Makerfabs/Maduino-Zero-4G-CAT1-A7670X/README.md

# Maduino-Zero-4G-CAT1-A7670X
Maduino Zero 4G LTE CAT1 A7670X
