Makerfabs/Maduino-Zero-4G-CAT1-A7670X/hardware/Maduino Zero 4G LTE A7670X v1.1.PDF

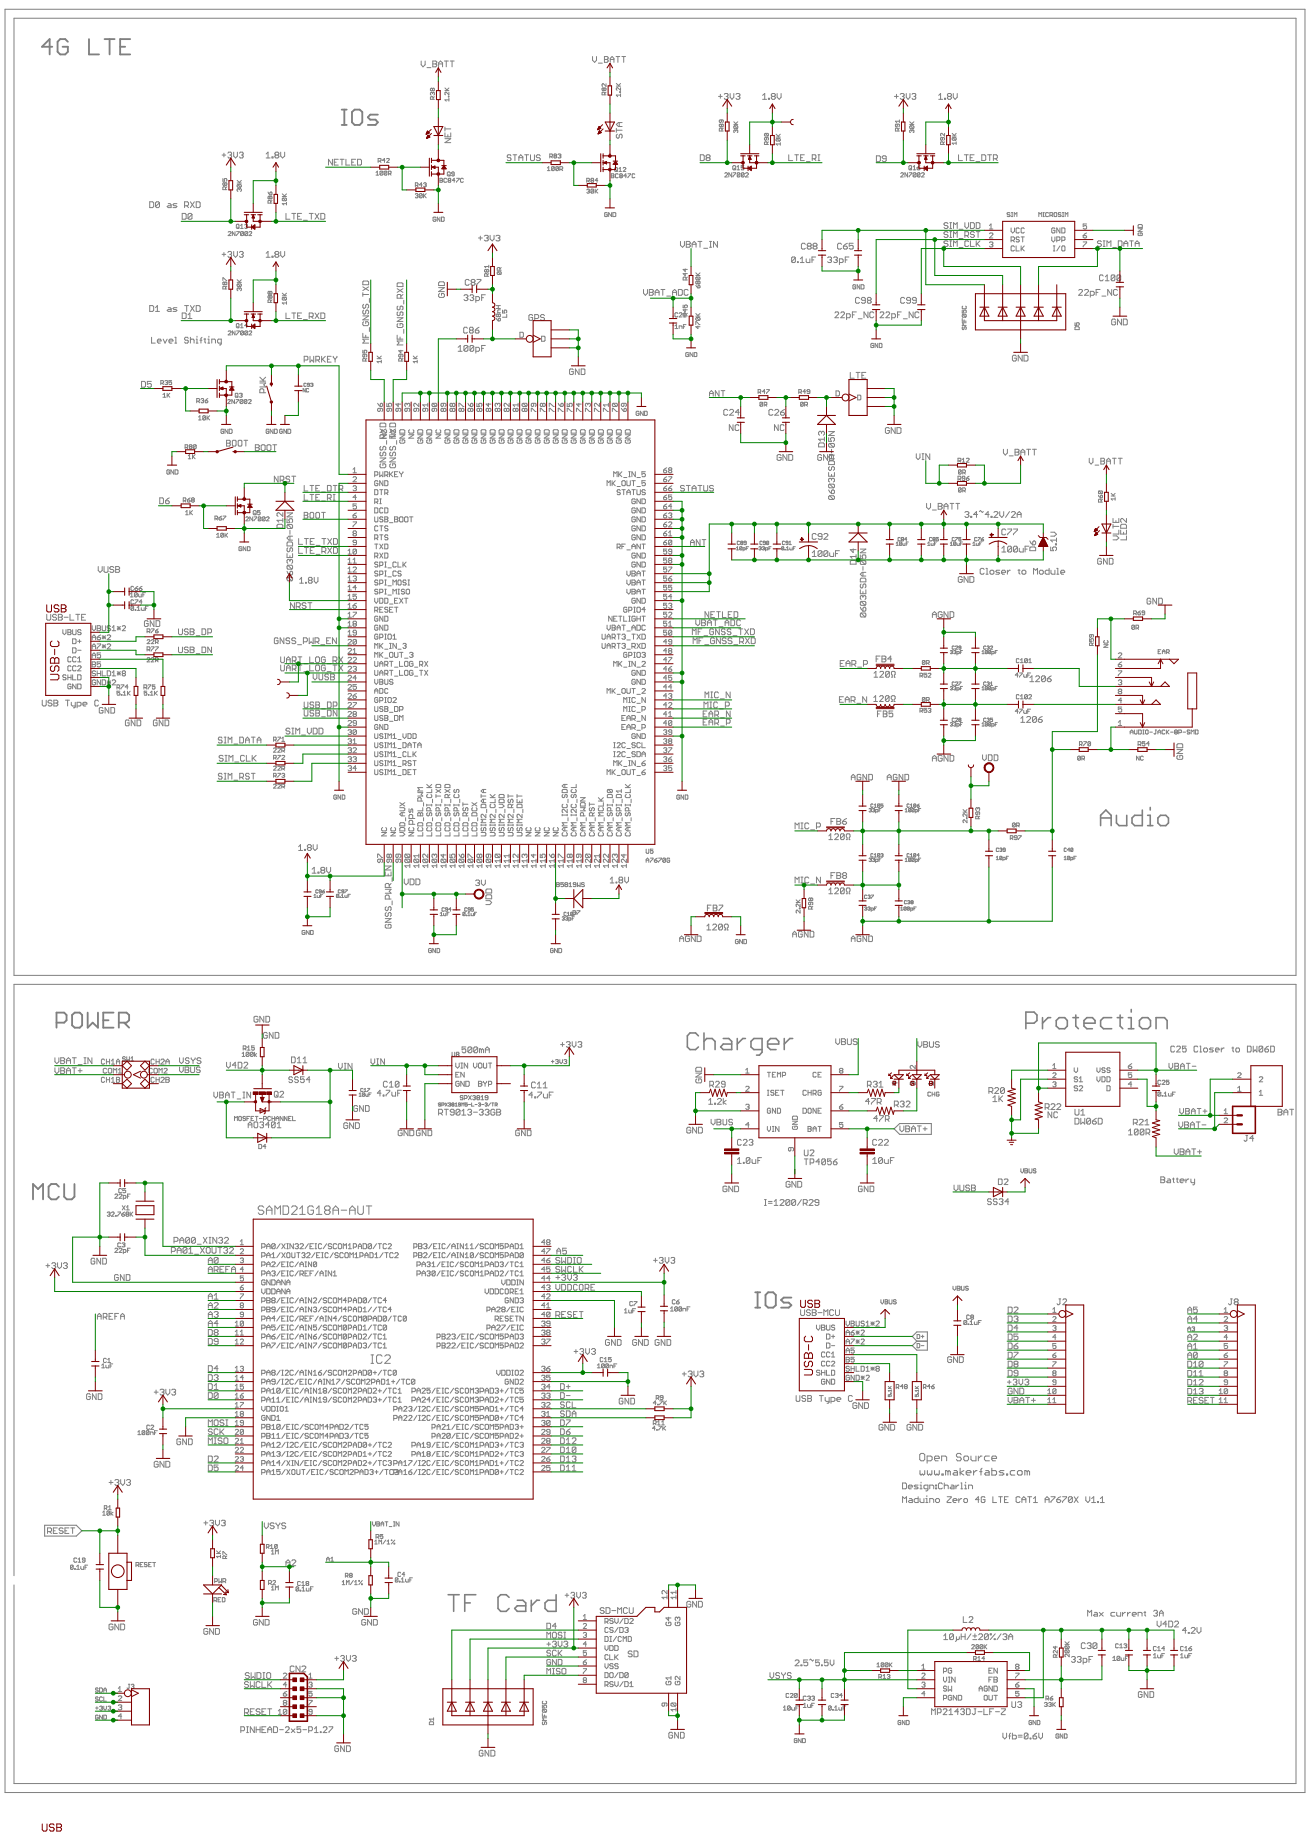
[picture p1: page 1]
