Makerfabs/Maduino-Zero-4G-CAT1-A7670X/hardware/Maduino Zero 4G LTE A7670X v1.1.brd

## EAGLE design hardware/Maduino Zero 4G LTE A7670X v1.1.brd (2023-10-08)

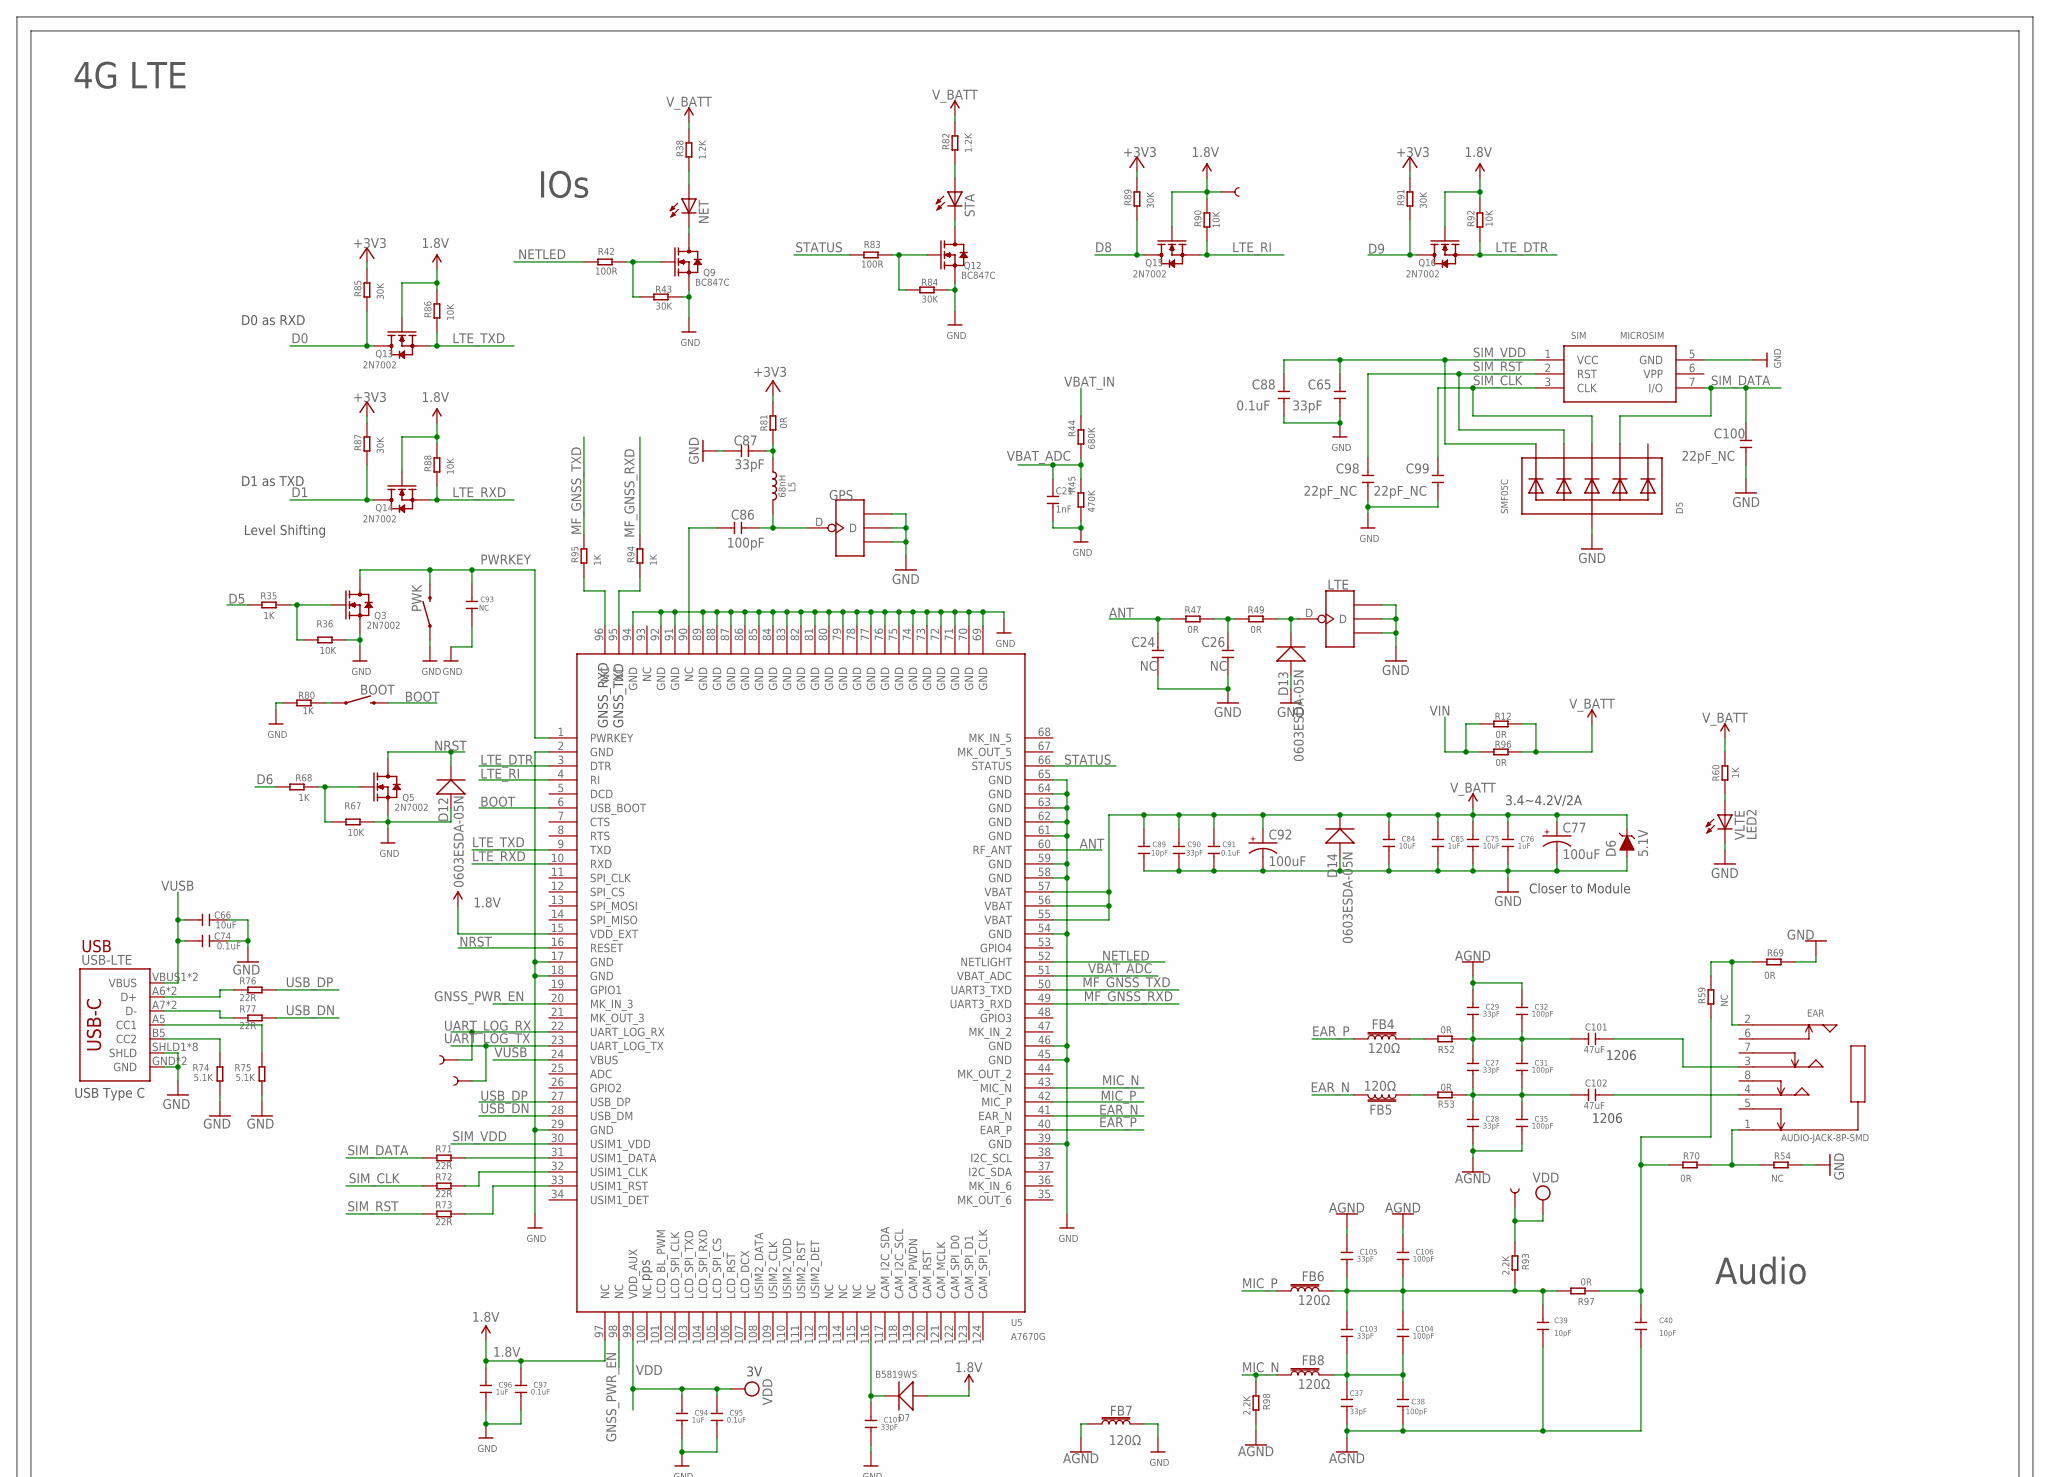
[picture p2: schematic Maduino Zero 4G LTE A7670X v1.1.sch, part in row 1, column 1]

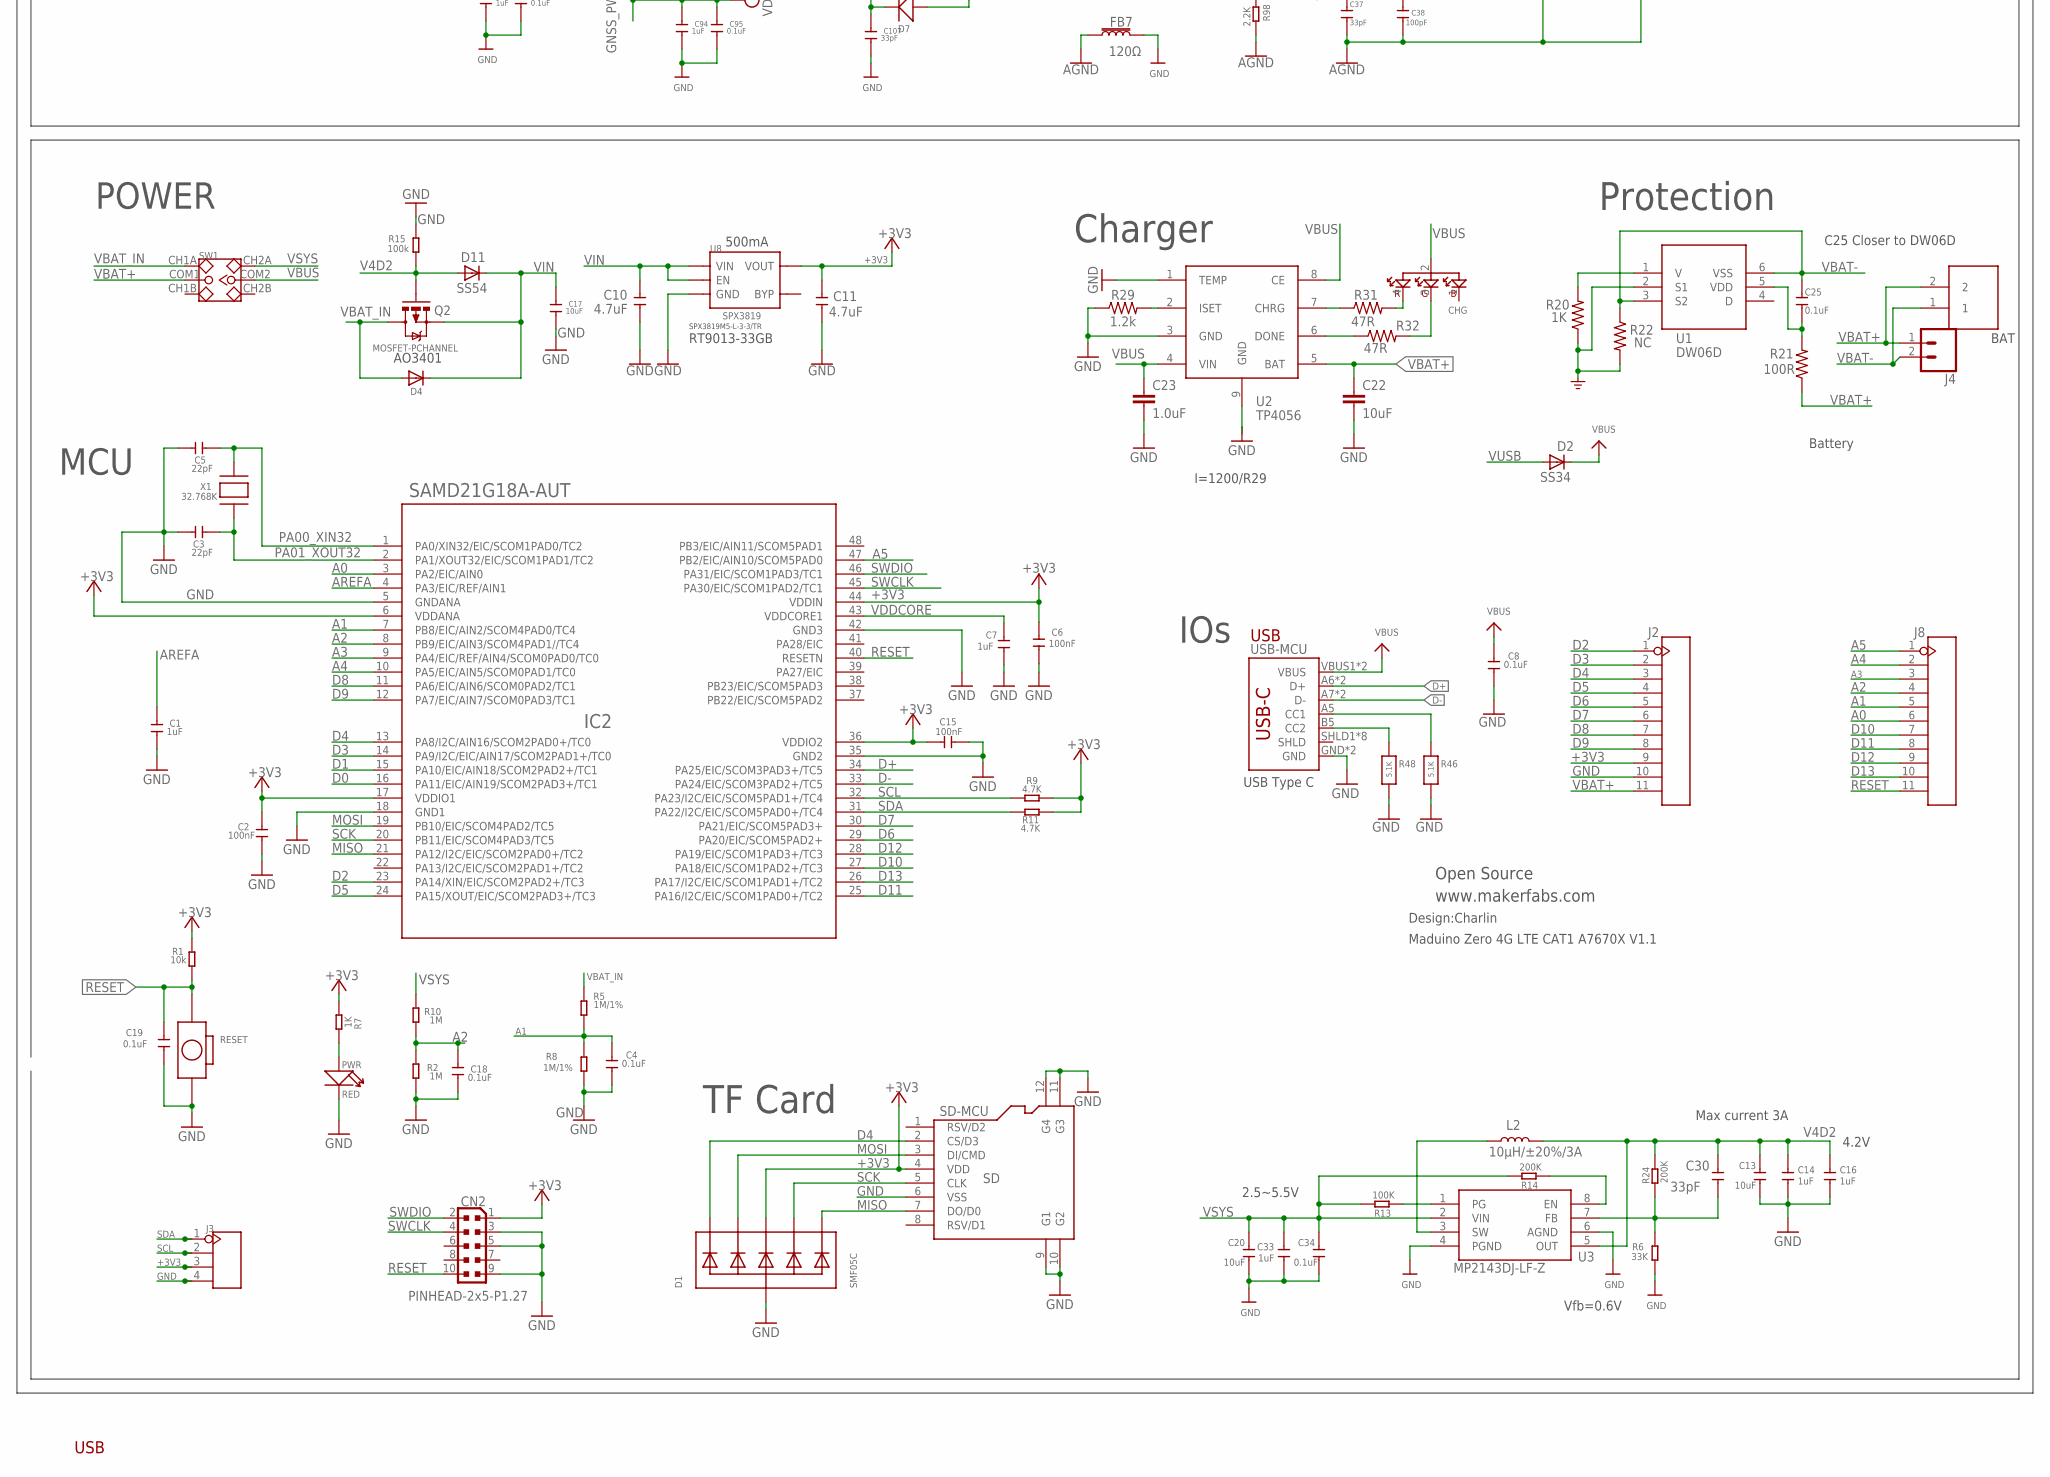
[picture p3: schematic Maduino Zero 4G LTE A7670X v1.1.sch, part in row 2, column 1]

Parts:
BAT: PH2.0-2P-90-DIP
BOOT: MOMENTARY-SWITCH-SPST-SMD-6.0X3.5MM; TACTILE_SWITCH_SMD_6.0X3.5MM
C1, C7, C14, C16, C33, C76, C85, C94, C96: 1uF; 0603
C2, C6, C15: 100nF; 0603
C3, C5: 22pF; 0603
C4, C8, C18, C19, C25, C34, C74, C88, C91, C95, C97: 0.1uF; 0603
C10, C11: 4.7uF; 0603
C13, C17, C20, C22, C66, C75, C84: 10uF; 0603
C21: 1nF; 0603
C23: 1.0uF; 0603
C24, C26, C93: NC; 0603
C27, C28, C29, C30, C37, C65, C87, C90, C103, C105, C107: 33pF; 0603
C31, C32, C35, C38, C86, C104, C106: 100pF; 0603
C39, C40, C89: 10pF; 0603
C77, C92: 100uF; EIA3528
C98, C99, C100: 22pF_NC; 0603
C101, C102: 47uF; DISCRETE_C1206
CHG: E6C0606RGBC3UDA; SMD4-160L160W
CN2: PINHEAD-2x5-P1.27; PINHEAD_2X05_127
D1, D5: SMF05C; SOT363
D2: SS34; DO-214AC
D4: DIODESOD-323F; SOD-323F
D6: 5.1V; SOD-323
D7: B5819WS; SOD323
D11: SS54; DO-214AC
D12, D13, D14: 0603ESDA-05N; DISCRETE_SOD523
EAR: AUDIO-JACK-8P-SMD; AUDIO8P-SMD-3.5-14.5X6.1X4.0MM
FB4, FB5, FB6, FB7, FB8: 120Ω; 0603
GPS: ANTENNA-U-FL; 4P-U-FL
IC2: SAMD21G18A-AUT; TQFP48-7X7
J2, J8: HEADER-11P-2.54; 11P-2.54
J3: HEADER-4P-60/35MILROUND; 4P-65/35ROUND
J4: CONN_02LOCK; 1X02_LOCK
L2: 10µH/±20%/3A; SRN6045
L5: 68nH; L0603
LTE: ANTENNA-U-FL; 4P-U-FL
NET: NET; CHIP-LED0805
PWK: MOMENTARY-SWITCH-SPST-SMD-6.0X3.5MM; TACTILE_SWITCH_SMD_6.0X3.5MM
PWR: RED; LED-0603
Q2: MOSFET-PCHANNEL; SOT23-3
Q3, Q5, Q13, Q14, Q15, Q16: 2N7002; SOT23
Q9, Q12: BC847C; SOT23
R1: 10k; R0603
R2, R10: 1M; R0603
R5, R8: 1M/1%; R0603
R6: 33K; R0603
R7, R35, R60, R68, R80, R94, R95: 1K; R0603
R9, R11: 4.7K; R0603
R12, R47, R49, R52, R53, R69, R70, R81, R96, R97: 0R; R0603
R13: 100K; R0603
R14, R24: 200K; R0603
R15: 100k; R0603
R20: 1K; 0603
R21: 100R; 0603
R22: NC; 0603
R29: 1.2k; 0603
R31, R32: 47R; 0603
R36, R67, R86, R88, R90, R92: 10K; R0603
R38, R82: 1.2K; R0603
R42, R83: 100R; R0603
R43, R84, R85, R87, R89, R91: 30K; R0603
R44: 680K; R0603
R45: 470K; R0603
R46, R48: 5.1K; 0603-NO
R54, R59: NC; R0603
R71, R72, R73, R76, R77: 22R; R0603
R74, R75: 5.1K; R0603
R93, R98: 2.2K; R0603
RESET: BOTTON-2P-90D; 2P-7.62X3.56-90D
SD-MCU: SD; 8P-SMD
SIM: MICROSIM
STA: NET; CHIP-LED0805
SW1: SWITCH-2CH-6P; 6P-2CH-2.54-7.6X3.0
TP1, TP2, TP3, TP6: TEST-POINT3; PAD.03X.03
U1: DW06D; SOT-23-6
U2: TP4056; SOP8-1.27P
U3: MP2143DJ-LF-Z; TSOT23-8
U5: A7670G
U8: SPX3819; SOT23-5
USB-LTE: USB_C5; USB-C-16P-5
USB-MCU: USB_C5; USB-C-16P-5
VLTE: LED2; CHIP-LED0805
X1: 32.768K; XTAL3215

Connections:
1.8V: C96.2, C97.2, D7.+, Q13.1 (G), Q14.1 (G), Q15.1 (G), Q16.1 (G), R86.2, R88.2, R90.2, R92.2, TP6.P$1, U5.15 (VDD_EXT), U5.97 (NC)
+3V3: C2.2, C6.1, C11.2, C15.1, CN2.1, D1.4 (C3), IC2.6 (VDDANA), IC2.17 (VDDIO1), IC2.36 (VDDIO2), IC2.44 (VDDIN), J2.9, J3.3, R1.2, R7.1, R9.2, R11.2, R81.2, R85.2, R87.2, R89.2, R91.2, SD-MCU.4 (VDD), U8.5 (VOUT)
A0: IC2.3 (PA2/EIC/AIN0), J8.6
A1: C4.1, IC2.7 (PB8/EIC/AIN2/SCOM4PAD0/TC4), J8.5, R5.1, R8.2
A2: C18.1, IC2.8 (PB9/EIC/AIN3/SCOM4PAD1//TC4), J8.4, R2.2, R10.1
A3: IC2.9 (PA4/EIC/REF/AIN4/SCOM0PAD0/TC0), J8.3
A4: IC2.10 (PA5/EIC/AIN5/SCOM0PAD1/TC0), J8.2
A5: IC2.47 (PB2/EIC/AIN10/SCOM5PAD0), J8.1
AGND: C28.1, C29.2, C32.2, C35.1, C37.1, C38.1, C39.1, C40.1, C105.2, C106.2, FB7.1, R98.2
ANT: C24.2, R47.1, U5.60 (RF_ANT)
AREFA: C1.1, IC2.4 (PA3/EIC/REF/AIN1)
BOOT: BOOT.2, U5.6 (USB_BOOT)
D0: IC2.16 (PA11/EIC/AIN19/SCOM2PAD3+/TC1), Q13.3 (D), R85.1
D1: IC2.15 (PA10/EIC/AIN18/SCOM2PAD2+/TC1), Q14.3 (D), R87.1
D2: IC2.23 (PA14/XIN/EIC/SCOM2PAD2+/TC3), J2.1
D3: IC2.14 (PA9/I2C/EIC/AIN17/SCOM2PAD1+/TC0), J2.2
D4: D1.1 (C1), IC2.13 (PA8/I2C/AIN16/SCOM2PAD0+/TC0), J2.3, SD-MCU.2 (CS/D3)
D5: IC2.24 (PA15/XOUT/EIC/SCOM2PAD3+/TC3), J2.4, R35.2
D6: IC2.29 (PA20/EIC/SCOM5PAD2+), J2.5, R68.2
D7: IC2.30 (PA21/EIC/SCOM5PAD3+), J2.6
D8: IC2.11 (PA6/EIC/AIN6/SCOM0PAD2/TC1), J2.7, Q15.3 (D), R89.1
D9: IC2.12 (PA7/EIC/AIN7/SCOM0PAD3/TC1), J2.8, Q16.3 (D), R91.1
D10: IC2.27 (PA18/EIC/SCOM1PAD2+/TC3), J8.7
D11: IC2.25 (PA16/I2C/EIC/SCOM1PAD0+/TC2), J8.8
D12: IC2.28 (PA19/EIC/SCOM1PAD3+/TC3), J8.9
D13: IC2.26 (PA17/I2C/EIC/SCOM1PAD1+/TC2), J8.10
D+: IC2.34 (PA25/EIC/SCOM3PAD3+/TC5), USB-MCU.A6 (D+), USB-MCU.B6 (D+)
D-: IC2.33 (PA24/EIC/SCOM3PAD2+/TC5), USB-MCU.A7 (D-), USB-MCU.B7 (D-)
DONE: R32.1, U2.6 (DONE)
EAR_N: FB5.2, U5.41 (EAR_N)
EAR_P: FB4.1, U5.40 (EAR_P)
GND: C1.2, C2.1, C3.2, C4.2, C5.2, C6.2, C7.2, C8.2, C10.1, C11.1, C13.1, C14.1, C15.2, C16.1, C17.1, C18.2, C19.1, C20.1, C21.2, C22.2, C23.2, C24.1, C26.1, C33.1, C34.1, C65.1, C66.2, C74.2, C75.1, C76.1, C77.C (-), C84.1, C85.1, C87.2, C88.1, C89.1, C90.1, C91.1, C92.C (-), C93.1, C94.1, C95.1, C96.1, C97.1, C98.1, C99.1, C100.1, C107.1, CN2.3, CN2.5, CN2.9, D1.2 (A), D5.2 (A), D6.A, D12.+, D13.+, D14.+, FB7.2, GPS.GND1, GPS.GND2, GPS.GND3, IC2.5 (GNDANA), IC2.18 (GND1), IC2.35 (GND2), IC2.42 (GND3), J2.10, J3.4, LTE.GND1, LTE.GND2, LTE.GND3, PWK.1, PWR.-, Q3.2 (S), Q5.2 (S), Q9.2 (S), Q12.2 (S), R2.1, R6.1, R8.1, R15.2, R20.1, R22.2, R29.1, R36.1, R43.1, R45.1, R46.2, R48.2, R54.2, R67.1, R69.2, R74.1, R75.1, R80.2, R84.1, RESET.P$2 (2), SD-MCU.6 (VSS), SD-MCU.9 (G1), SD-MCU.10 (G2), SD-MCU.11 (G3), SD-MCU.12 (G4), SIM.5 (GND), U1.2 (S1), U2.1 (TEMP), U2.3 (GND), U2.9 (GND), U3.4 (PGND), U3.6 (AGND), U5.2 (GND), U5.17 (GND), U5.18 (GND), U5.29 (GND), U5.39 (GND), U5.45 (GND), U5.46 (GND), U5.54 (GND), U5.58 (GND), U5.59 (GND), U5.61 (GND), U5.62 (GND), U5.63 (GND), U5.64 (GND), U5.65 (GND), U5.69 (GND), U5.70 (GND), U5.71 (GND), U5.72 (GND), U5.73 (GND), U5.74 (GND), U5.75 (GND), U5.76 (GND), U5.77 (GND), U5.78 (GND), U5.79 (GND), U5.80 (GND), U5.81 (GND), U5.82 (GND), U5.83 (GND), U5.84 (GND), U5.85 (GND), U5.86 (GND), U5.87 (GND), U5.88 (GND), U5.89 (GND), U5.91 (GND), U5.92 (GND), U5.94 (GND), U8.2 (GND), USB-LTE.GND, USB-LTE.GND2 (GND), USB-LTE.SHLD1 (SHLD), USB-LTE.SHLD2 (SHLD), USB-LTE.SHLD3 (SHLD), USB-LTE.SHLD4 (SHLD), USB-LTE.SHLD5 (SHLD), USB-LTE.SHLD6 (SHLD), USB-LTE.SHLD7 (SHLD), USB-LTE.SHLD8 (SHLD), USB-MCU.GND, USB-MCU.GND2 (GND), VLTE.C
GNSS_PWR_EN: U5.20 (MK_IN_3), U5.98 (NC)
ISET: R29.2, U2.2 (ISET)
LTE_DTR: Q16.2 (S), R92.1, U5.3 (DTR)
LTE_RI: Q15.2 (S), R90.1, U5.4 (RI)
LTE_RXD: Q14.2 (S), R88.1, U5.10 (RXD)
LTE_TXD: Q13.2 (S), R86.1, U5.9 (TXD)
MF_GNSS_RXD: R94.2, U5.49 (UART3_RXD)
MF_GNSS_TXD: R95.2, U5.50 (UART3_TXD)
MIC_N: FB8.1, R98.1, U5.43 (MIC_N)
MIC_P: FB6.1, U5.42 (MIC_P)
MISO: D1.6 (C5), IC2.21 (PA12/I2C/EIC/SCOM2PAD0+/TC2), SD-MCU.7 (DO/D0)
MOSI: D1.3 (C2), IC2.19 (PB10/EIC/SCOM4PAD2/TC5), SD-MCU.3 (DI/CMD)
unnamed: PWR.+, R7.2
unnamed: L2.1, U3.3 (SW)
unnamed: C25.2, R21.2, U1.5 (VDD)
unnamed: R20.2, U1.1 (V)
unnamed: CHG.3, R32.2
unnamed: R31.1, U2.7 (CHRG)
unnamed: R13.1, U3.1 (PG)
unnamed: C30.1, R6.2, R24.1, U3.7 (FB)
unnamed: R14.1, U3.8 (EN)
unnamed: CHG.4, R31.2
unnamed: Q9.1 (G), R42.1, R43.2
unnamed: NET.A, R38.1
unnamed: R46.1, USB-MCU.A5 (CC1)
unnamed: R48.1, USB-MCU.B5 (CC2)
unnamed: NET.C, Q9.3 (D)
unnamed: C26.2, R47.2, R49.1
unnamed: D13.-, LTE.D, R49.2
unnamed: FB4.2, R52.2
unnamed: C101.2, EAR.3
unnamed: C27.1, C28.2, C31.1, C35.2, C102.1, R53.1
unnamed: C40.2, R59.1, R70.1, R97.1
unnamed: C39.2, C103.2, C104.2, C105.1, C106.1, FB6.2, R93.2, R97.2
unnamed: EAR.2, R59.2, R69.1
unnamed: EAR.1, R54.1, R70.2
unnamed: FB5.1, R53.2
unnamed: R71.1, U5.31 (USIM1_DATA)
unnamed: Q3.1 (G), R35.1, R36.2
unnamed: R72.1, U5.32 (USIM1_CLK)
unnamed: R73.1, U5.33 (USIM1_RST)
unnamed: R60.1, VLTE.A
unnamed: R75.2, USB-LTE.A5 (CC1)
unnamed: R74.2, USB-LTE.B5 (CC2)
unnamed: R76.2, USB-LTE.A6 (D+), USB-LTE.B6 (D+)
unnamed: R77.2, USB-LTE.A7 (D-), USB-LTE.B7 (D-)
unnamed: BOOT.1, R80.1
unnamed: C87.1, L5.1, R81.1
unnamed: C86.1, GPS.D, L5.2
unnamed: C86.2, U5.90 (NC)
unnamed: Q12.1 (G), R83.1, R84.2
unnamed: R82.1, STA.A
unnamed: Q5.1 (G), R67.2, R68.1
unnamed: Q12.3 (D), STA.C
unnamed: C27.2, C29.1, C31.2, C32.1, C101.1, R52.1
unnamed: C102.2, EAR.4
unnamed: R94.1, U5.95 (NC)
unnamed: R95.1, U5.96 (NC)
unnamed: C37.2, C38.2, C103.1, C104.1, FB8.2
unnamed: C107.2, D7.-, U5.116 (NC)
NETLED: R42.2, U5.52 (NETLIGHT)
NRST: D12.-, Q5.3 (D), U5.16 (RESET)
PA00_XIN32: C5.1, IC2.1 (PA0/XIN32/EIC/SCOM1PAD0/TC2), X1.P$2
PA01_XOUT32: C3.1, IC2.2 (PA1/XOUT32/EIC/SCOM1PAD1/TC2), X1.P$1
PWRKEY: C93.2, PWK.2, Q3.3 (D), U5.1 (PWRKEY)
RESET: C19.2, CN2.10, IC2.40 (RESETN), J8.11, R1.1, RESET.P$1 (1)
SCK: D1.5 (C4), IC2.20 (PB11/EIC/SCOM4PAD3/TC5), SD-MCU.5 (CLK)
SCL: IC2.32 (PA23/I2C/EIC/SCOM5PAD1+/TC4), J3.2, R9.1
SDA: IC2.31 (PA22/I2C/EIC/SCOM5PAD0+/TC4), J3.1, R11.1
SIM_CLK: C99.2, D5.4 (C3), R72.2, SIM.3 (CLK)
SIM_DATA: C100.2, D5.3 (C2), R71.2, SIM.7 (I/O)
SIM_RST: C98.2, D5.5 (C4), R73.2, SIM.2 (RST)
SIM_VDD: C65.2, C88.2, D5.6 (C5), SIM.1 (VCC), U5.30 (USIM1_VDD)
STATUS: R83.2, U5.66 (STATUS)
SWCLK: CN2.4, IC2.45 (PA30/EIC/SCOM1PAD2/TC1)
SWDIO: CN2.2, IC2.46 (PA31/EIC/SCOM1PAD3/TC1)
UART_LOG_RX: TP3.P$1, U5.22 (UART_LOG_RX)
UART_LOG_TX: TP2.P$1, U5.23 (UART_LOG_TX)
USB_DN: R77.1, U5.28 (USB_DM)
USB_DP: R76.1, U5.27 (USB_DP)
V4D2: C13.2, C14.2, C16.2, C30.2, D11.A, L2.2, Q2.1 (G), R15.1, R24.2, U3.5 (OUT)
VBAT+: BAT.2, C22.1, J2.11, J4.1, R21.1, SW1.COM1, U2.5 (BAT)
VBAT-: BAT.1, C25.1, J4.2, R22.1, U1.3 (S2), U1.6 (VSS)
VBAT_ADC: C21.1, R44.1, R45.2, U5.51 (VBAT_ADC)
VBAT_IN: D4.A, Q2.3 (D), R5.2, R44.2, SW1.CH1A
VBUS: C8.1, C23.1, CHG.2, D2.C, SW1.COM2, U2.4 (VIN), U2.8 (CE), USB-MCU.VBUS1 (VBUS), USB-MCU.VBUS2 (VBUS)
VDD: C94.2, C95.2, R93.1, TP1.P$1, U5.99 (VDD_AUX)
VDDCORE: C7.1, IC2.43 (VDDCORE1)
VIN: C10.2, C17.2, D4.C, D11.C, Q2.2 (S), R12.2, R96.2, U8.1 (VIN), U8.3 (EN)
VSYS: C20.2, C33.2, C34.2, R10.2, R13.2, R14.2, SW1.CH2A, U3.2 (VIN)
VUSB: C66.1, C74.1, D2.A, U5.24 (VBUS), USB-LTE.VBUS1 (VBUS), USB-LTE.VBUS2 (VBUS)
V_BATT: C75.2, C76.2, C77.A (+), C84.2, C85.2, C89.2, C90.2, C91.2, C92.A (+), D6.C, D14.-, R12.1, R38.2, R60.2, R82.2, R96.1, U5.55 (VBAT), U5.56 (VBAT), U5.57 (VBAT)

Notes on the sheet:
500mA
www.makerfabs.com
MCU
IOs
POWER
Design:Charlin
Open Source
AO3401
Maduino Zero 4G LTE CAT1 A7670X V1.1
Battery
C25 Closer to DW06D
Protection
BAT
I=1200/R29
Level Shifting
USB
USB Type C
Audio
Charger
TF Card
D0 as RXD
D1 as TXD
SPX3819M5-L-3-3/TR
RT9013-33GB
Closer to Module
3.4~4.2V/2A
GNSS_TXD
GNSS_RXD
1206
4G LTE
pps
4.2V
Max current 3A
Vfb=0.6V
2.5~5.5V

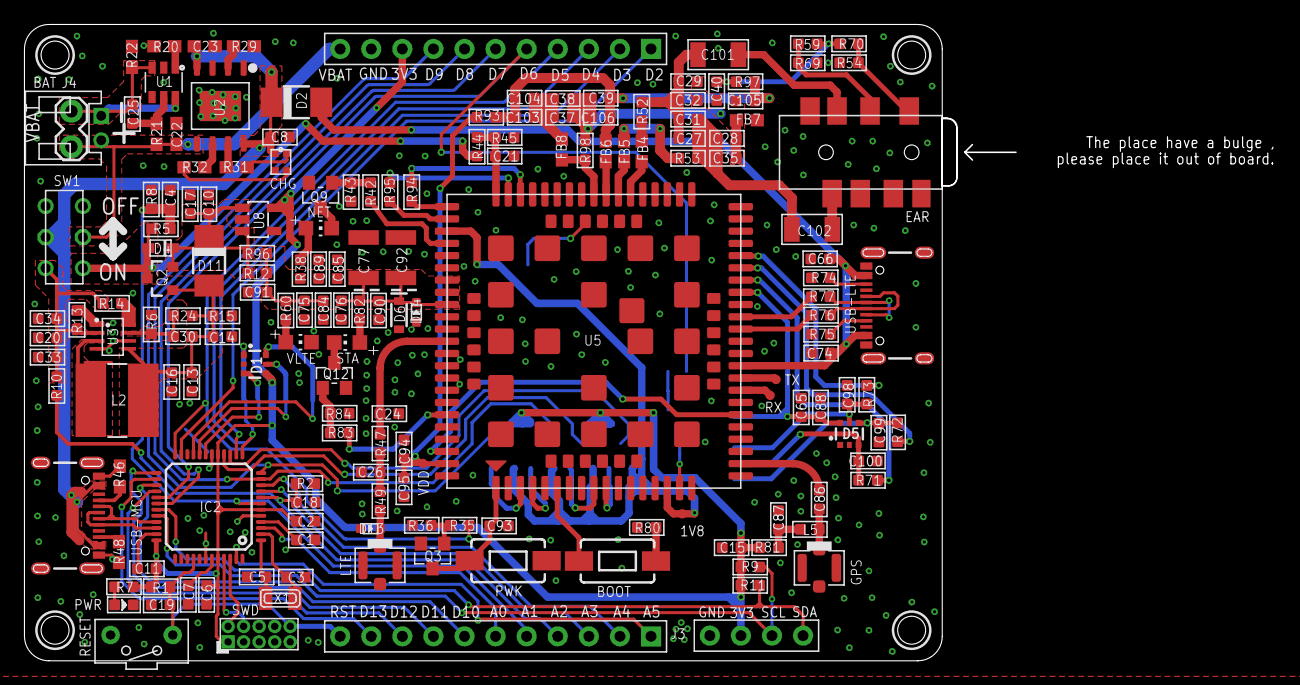
[picture p4: board Maduino Zero 4G LTE A7670X v1.1.brd from above]

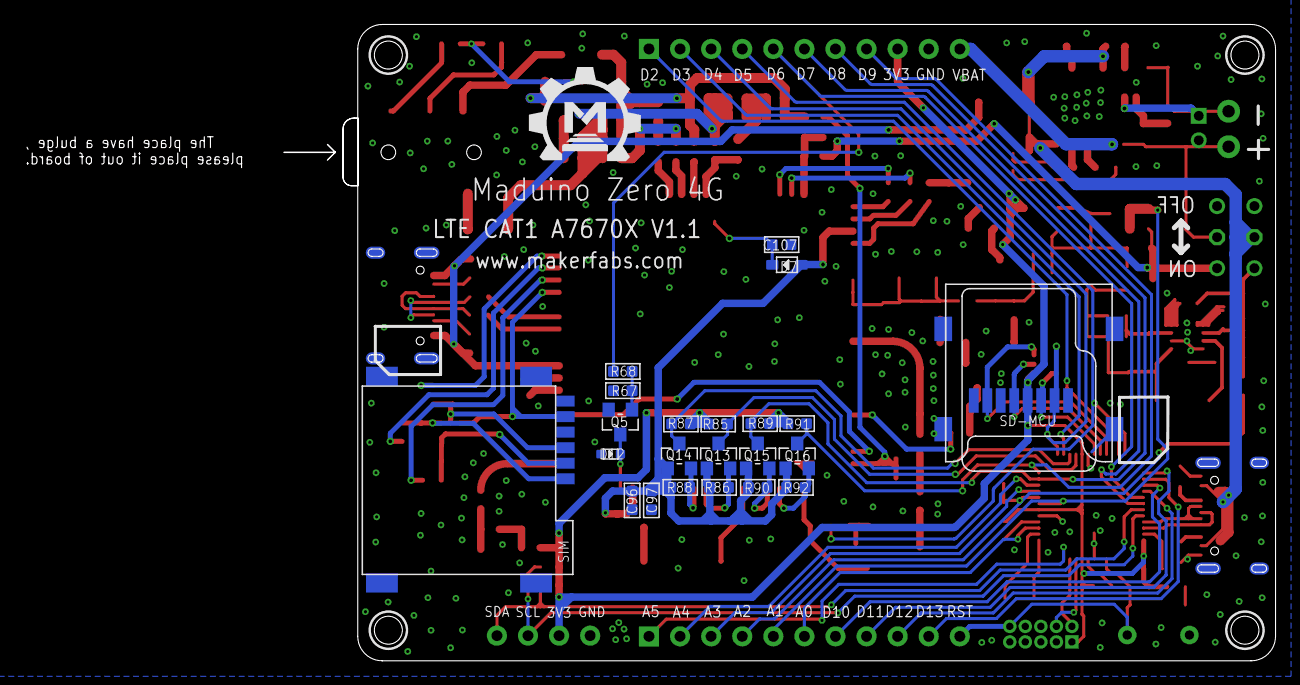
[picture p5: board Maduino Zero 4G LTE A7670X v1.1.brd from below]

Board: 2 copper layers, 81.0 x 52.0 mm, 193 parts (23 on the bottom side), 124 nets.

Other parts of the board:
U$1: MAKERFABS_0.3
