Makerfabs/Maduino-Zero-4G-CAT1-A7670X/(notices)

Notices in the files:
parts and their libraries:
microbuilder: This work is placed in the public domain, and may be freely used for commercial and non-commercial work with the following conditions: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
User-Submitted: Licensing: Creative Commons ShareAlike 4.0 International - https://creativecommons.org/licenses/by-sa/4.0
